t123yh/BM32/BM32/BM32.kicad_pcb

## KiCad design BM32/BM32.kicad_pcb (2022-07-28)

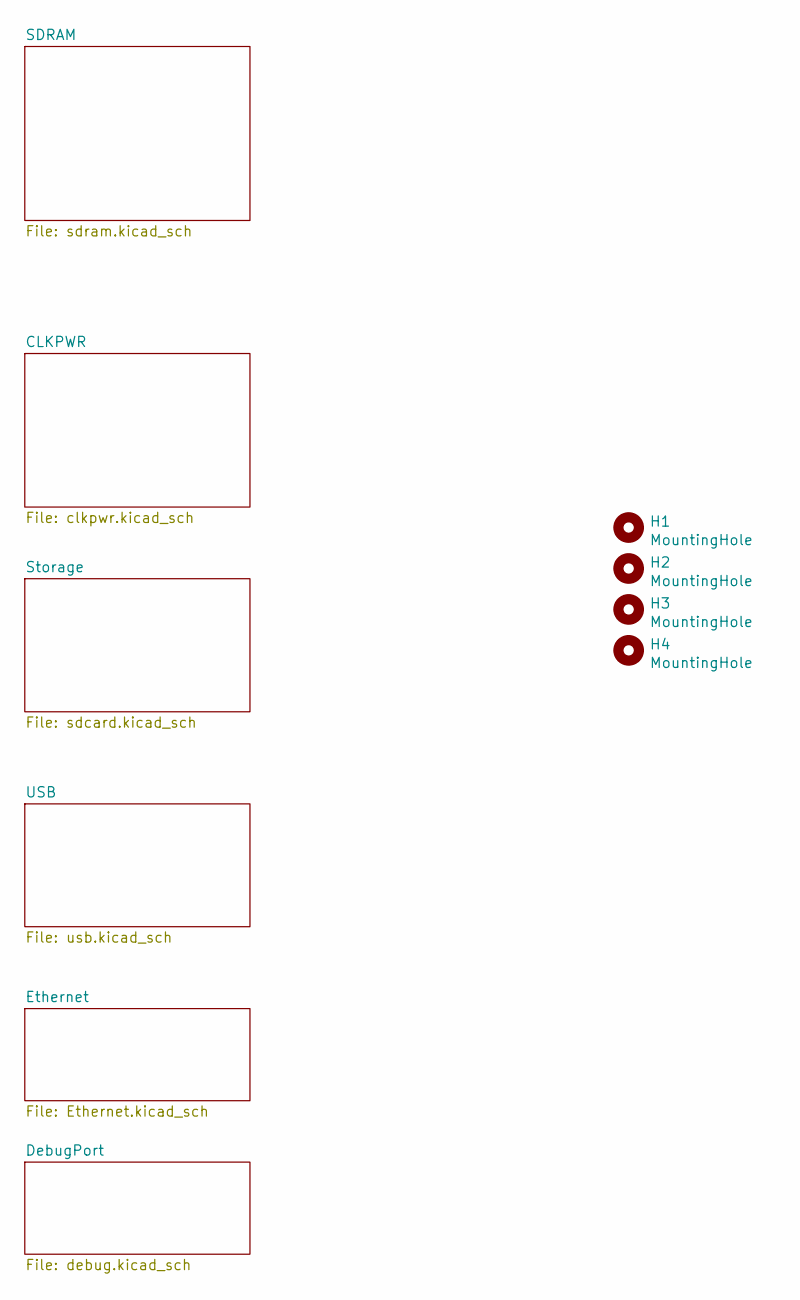
[picture p1: schematic BM32.kicad_sch]

Parts:
H1, H2, H3, H4: MountingHole; MountingHole_3.2mm_M3

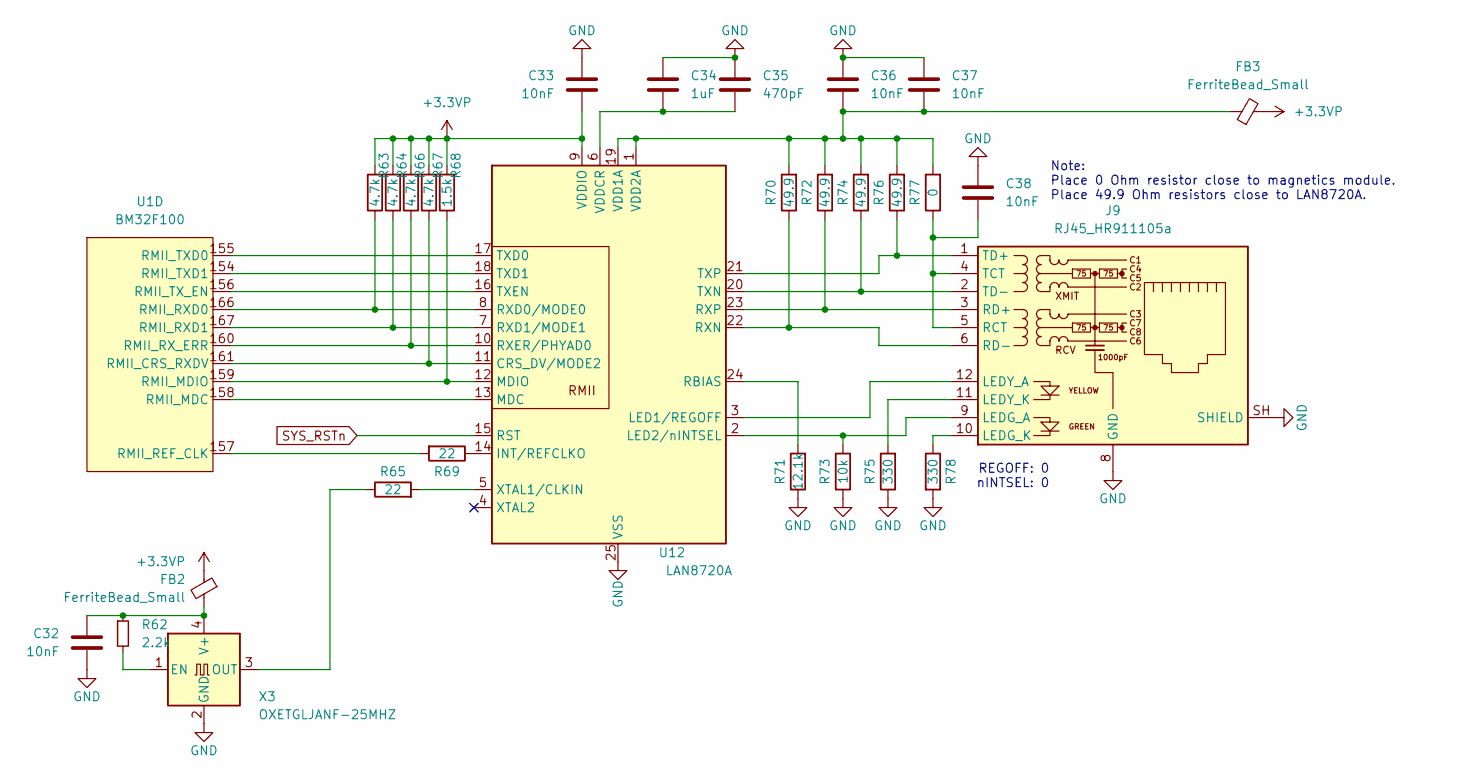
[picture p2: schematic Ethernet.kicad_sch, Ethernet Phy]

Parts:
C32, C33, C36, C37, C38: 10nF; 0402_C
C34: 1uF; 0402_C
C35: 470pF; 0402_C
FB2, FB3: FerriteBead_Small; 0805_L
J9: RJ45_HR911105a; RJ45_Hanrun_HR911105A
R62: 2.2k; 0402_R
R63, R64, R66, R67: 4.7k; 0402_R
R65, R69: 22; 0402_R
R68: 1.5k; 0402_R
R70, R72, R74, R76: 49.9; 0402_R
R71: 12.1k; 0402_R
R73: 10k; 0402_R
R75, R78: 330; 0402_R
R77: 0; 0402_R
U1: BM32F100; VQFP-176_20x20mm_P0.4mm
U12: LAN8720A; QFN-24-1EP_4x4mm_P0.5mm_EP2.6x2.6mm_ThermalVias
X3: OXETGLJANF-25MHZ; SMD-3225_4P

Connections:
+3.3VP: C33.2, FB2.1, FB3.2, R63.2, R64.2, R66.2, R67.2, R68.2, U12.9 (VDDIO); also elsewhere on the board
GND: C32.1, C33.1, C34.1, C35.1, C36.1, C37.1, C38.1, J9.8 (GND), J9.SH (SHIELD), R71.1, R73.1, R75.1, R78.2, U12.25 (VSS), X3.2 (GND); also elsewhere on the board
unnamed: C32.2, FB2.2, R62.1, X3.4 (V+)
unnamed: C34.2, C35.2, U12.6 (VDDCR)
unnamed: C36.2, C37.2, FB3.1, R70.2, R72.2, R74.2, R76.2, R77.2, U12.1 (VDD2A), U12.19 (VDD1A)
unnamed: C38.2, J9.4 (TCT), J9.5 (RCT), R77.1
unnamed: J9.1 (TD+), R76.1, U12.21 (TXP)
unnamed: J9.2 (TD-), R74.1, U12.20 (TXN)
unnamed: J9.3 (RD+), R72.1, U12.23 (RXP)
unnamed: J9.6 (RD-), R70.1, U12.22 (RXN)
unnamed: J9.9 (LEDG_A), R73.2, U12.2 (LED2/nINTSEL)
unnamed: J9.10 (LEDG_K), R78.1
unnamed: J9.11 (LEDY_K), R75.2
unnamed: J9.12 (LEDY_A), U12.3 (LED1/REGOFF)
unnamed: R62.2, X3.1 (EN)
unnamed: R63.1, U1.166 (RMII_RXD0), U12.8 (RXD0/MODE0)
unnamed: R64.1, U1.167 (RMII_RXD1), U12.7 (RXD1/MODE1)
unnamed: R65.1, X3.3 (OUT)
unnamed: R65.2, U12.5 (XTAL1/CLKIN)
unnamed: R66.1, U1.160 (RMII_RX_ERR), U12.10 (RXER/PHYAD0)
unnamed: R67.1, U1.161 (RMII_CRS_RXDV), U12.11 (CRS_DV/MODE2)
unnamed: R68.1, U1.159 (RMII_MDIO), U12.12 (MDIO)
unnamed: R69.1, U12.14 (INT/REFCLKO)
unnamed: R69.2, U1.157 (RMII_REF_CLK)
unnamed: R71.2, U12.24 (RBIAS)
unnamed: U1.154 (RMII_TXD1), U12.18 (TXD1)
unnamed: U1.155 (RMII_TXD0), U12.17 (TXD0)
unnamed: U1.156 (RMII_TX_EN), U12.16 (TXEN)
unnamed: U1.158 (RMII_MDC), U12.13 (MDC)
SYS_RSTn: U12.15 (RST); also elsewhere on the board

Notes on the sheet:
REGOFF: 0 nINTSEL: 0
Note: Place 0 Ohm resistor close to magnetics module. Place 49.9 Ohm resistors close to LAN8720A.

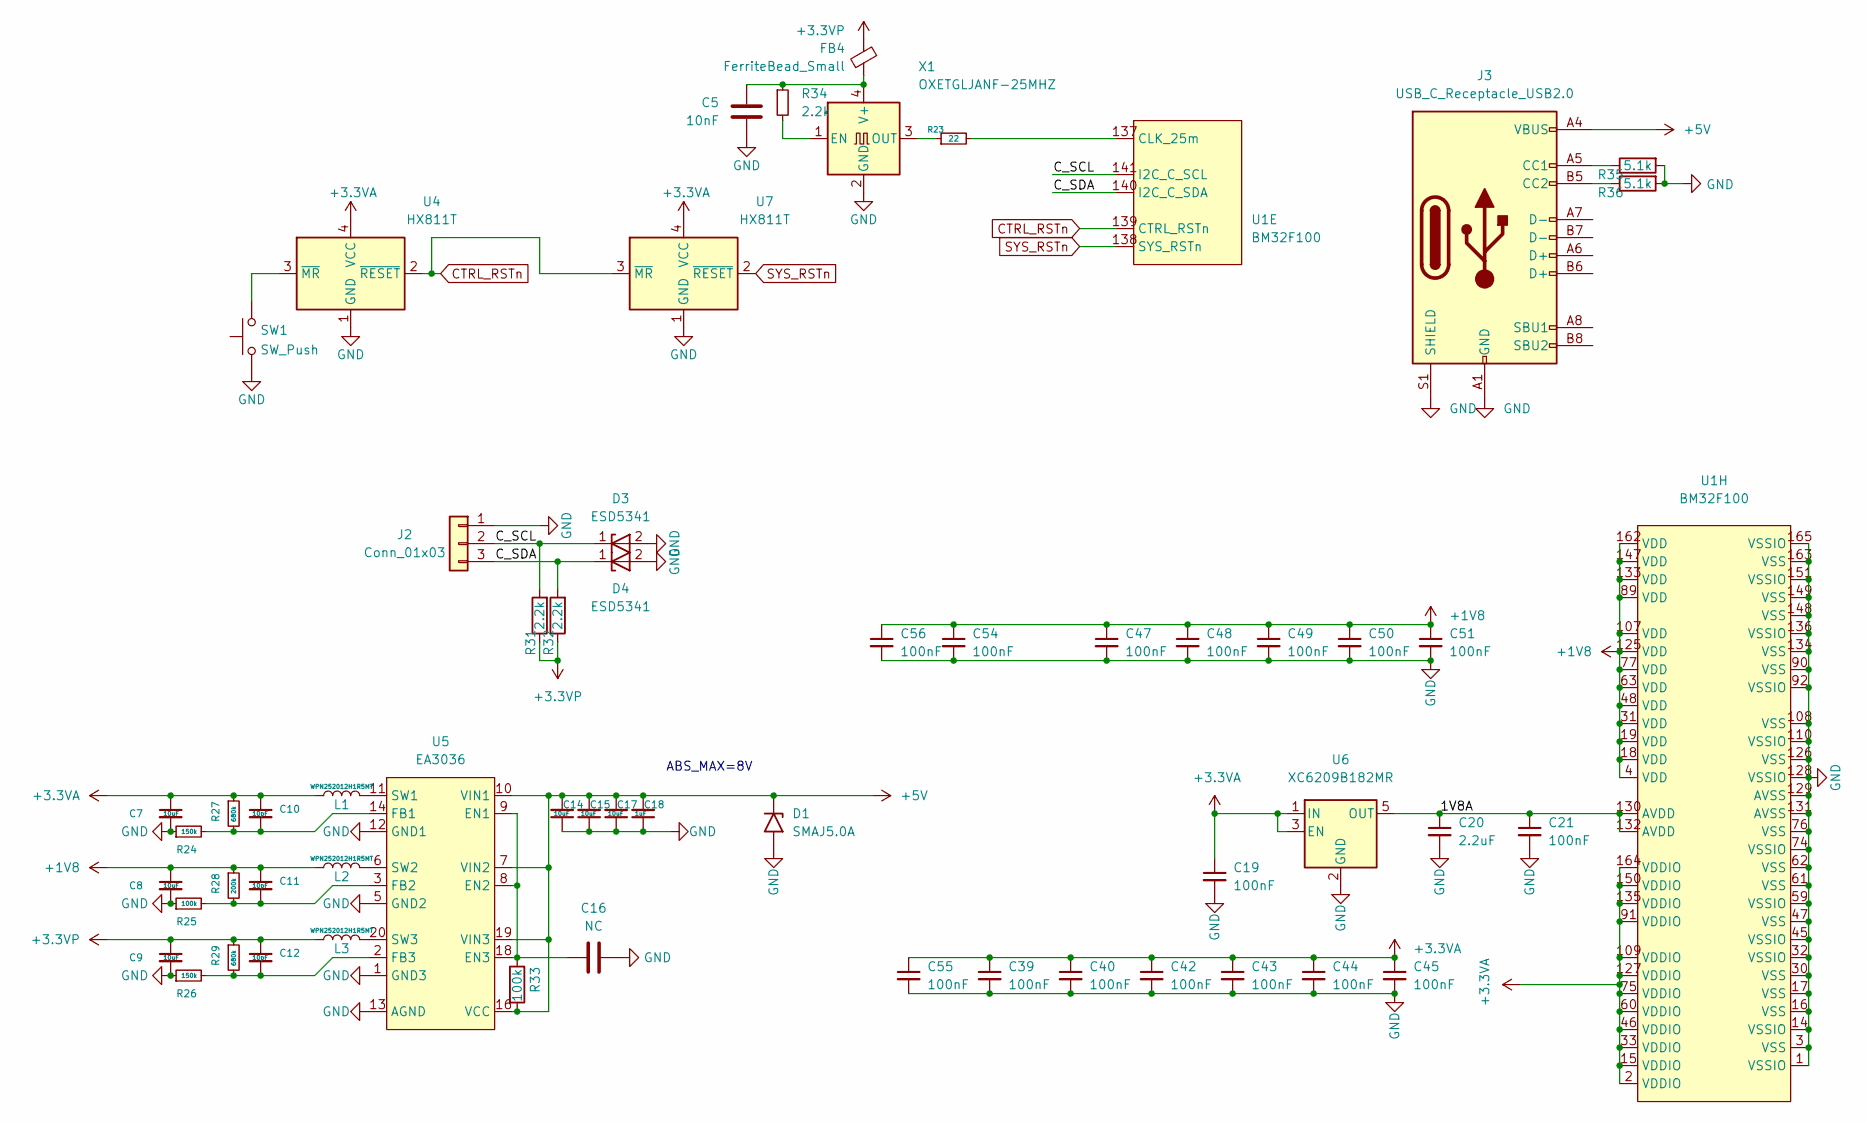
[picture p3: schematic clkpwr.kicad_sch, Clock and Power]

Parts:
C5: 10nF; 0402_C
C7, C8, C9, C14, C15, C17: 10uF; 0805_C
C10, C11, C12: 10pF; 0402_C
C16: NC; 0402_C
C18: 1uF; 0402_C
C19, C21, C39, C40, C42, C43, C44, C45, C47, C48, C49, C50, C51, C54, C55, C56: 100nF; 0402_C
C20: 2.2uF; 0402_C
D1: SMAJ5.0A; D_SMA
D3, D4: ESD5341; 0402_R
FB4: FerriteBead_Small; 0805_L
J2: Conn_01x03; PinHeader_1x03_P2.54mm_Vertical
J3: USB_C_Receptacle_USB2.0; USB_C_Receptacle_HRO_TYPE-C-31-M-12
L1, L2, L3: WPN252012H1R5MT; L_1008_2520Metric
R23: 22; 0402_R
R24, R26: 150k; 0402_R
R25, R33: 100k; 0402_R
R27, R29: 680k; 0402_R
R28: 200k; 0402_R
R31, R32, R34: 2.2k; 0402_R
R35, R36: 5.1k; 0402_R
SW1: SW_Push; SW_Push_SPST_NO_Alps_SKRK
U1: BM32F100; VQFP-176_20x20mm_P0.4mm
U4, U7: HX811T; SOT-143
U5: EA3036; QFN-20-1EP_3x3mm_P0.4mm_EP1.65x1.65mm_ThermalVias
U6: XC6209B182MR; SOT-23-5
X1: OXETGLJANF-25MHZ; SMD-3225_4P

Connections:
+1V8: C8.1, C11.1, C47.1, C48.1, C49.1, C50.1, C51.1, C54.1, C56.1, L2.1, R28.1, U1.4 (VDD), U1.18 (VDD), U1.19 (VDD), U1.31 (VDD), U1.48 (VDD), U1.63 (VDD), U1.77 (VDD), U1.89 (VDD), U1.107 (VDD), U1.125 (VDD), U1.133 (VDD), U1.147 (VDD), U1.162 (VDD); also elsewhere on the board
+3.3VA: C7.1, C10.1, C19.1, C39.1, C40.1, C42.1, C43.1, C44.1, C45.1, C55.1, L1.1, R27.1, U1.2 (VDDIO), U1.15 (VDDIO), U1.33 (VDDIO), U1.46 (VDDIO), U1.60 (VDDIO), U1.75 (VDDIO), U1.91 (VDDIO), U1.109 (VDDIO), U1.127 (VDDIO), U1.135 (VDDIO), U1.150 (VDDIO), U1.164 (VDDIO), U4.4 (VCC), U6.1 (IN), U6.3 (EN), U7.4 (VCC); also elsewhere on the board
+3.3VP: C9.1, C12.1, FB4.1, L3.1, R29.1, R31.1, R32.1; also elsewhere on the board
+5V: C14.2, C15.2, C17.2, C18.2, D1.1 (A1), J3.A4 (VBUS), J3.A9 (VBUS), J3.B4 (VBUS), J3.B9 (VBUS), R33.2, U5.7 (VIN2), U5.10 (VIN1), U5.16 (VCC), U5.19 (VIN3); also elsewhere on the board
/CLKPWR/1V8A: C20.1, C21.1, U1.130 (AVDD), U1.132 (AVDD), U6.5 (OUT)
/CLKPWR/C_SCL: D3.1, J2.2, R31.2, U1.141 (I2C_C_SCL)
/CLKPWR/C_SDA: D4.1, J2.3, R32.2, U1.140 (I2C_C_SDA)
CTRL_RSTn: U1.139 (CTRL_RSTn), U4.2 (~RESET), U7.3 (~MR)
GND: C5.1, C7.2, C8.2, C9.2, C14.1, C15.1, C16.2, C17.1, C18.1, C19.2, C20.2, C21.2, C39.2, C40.2, C42.2, C43.2, C44.2, C45.2, C47.2, C48.2, C49.2, C50.2, C51.2, C54.2, C55.2, C56.2, D1.2 (A2), D3.2, D4.2, J2.1, J3.A1 (GND), J3.A12 (GND), J3.B1 (GND), J3.B12 (GND), J3.S1 (SHIELD), R24.1, R25.1, R26.1, R35.2, R36.2, SW1.1, U1.1 (VSSIO), U1.3 (VSS), U1.14 (VSSIO), U1.16 (VSS), U1.17 (VSS), U1.30 (VSS), U1.32 (VSSIO), U1.45 (VSSIO), U1.47 (VSS), U1.59 (VSSIO), U1.61 (VSS), U1.62 (VSS), U1.74 (VSSIO), U1.76 (VSS), U1.90 (VSS), U1.92 (VSSIO), U1.108 (VSS), U1.110 (VSSIO), U1.126 (VSS), U1.128 (VSSIO), U1.129 (AVSS), U1.131 (AVSS), U1.134 (VSS), U1.136 (VSSIO), U1.148 (VSS), U1.149 (VSS), U1.151 (VSSIO), U1.163 (VSS), U1.165 (VSSIO), U4.1 (GND), U5.1 (GND3), U5.4 (AGND), U5.5 (GND2), U5.12 (GND1), U5.13 (AGND), U5.15 (AGND), U5.17 (AGND), U5.21 (EP), U6.2 (GND), U7.1 (GND), X1.2 (GND); also elsewhere on the board
unnamed: C5.2, FB4.2, R34.1, X1.4 (V+)
unnamed: C10.2, R24.2, R27.2, U5.14 (FB1)
unnamed: C11.2, R25.2, R28.2, U5.3 (FB2)
unnamed: C12.2, R26.2, R29.2, U5.2 (FB3)
unnamed: C16.1, R33.1, U5.8 (EN2), U5.9 (EN1), U5.18 (EN3)
unnamed: J3.A5 (CC1), R35.1
unnamed: J3.B5 (CC2), R36.1
unnamed: L1.2, U5.11 (SW1)
unnamed: L2.2, U5.6 (SW2)
unnamed: L3.2, U5.20 (SW3)
unnamed: R23.1, X1.3 (OUT)
unnamed: R23.2, U1.137 (CLK_25m)
unnamed: R34.2, X1.1 (EN)
unnamed: SW1.2, U4.3 (~MR)
SYS_RSTn: U1.138 (SYS_RSTn), U7.2 (~RESET); also elsewhere on the board

Notes on the sheet:
ABS_MAX=8V

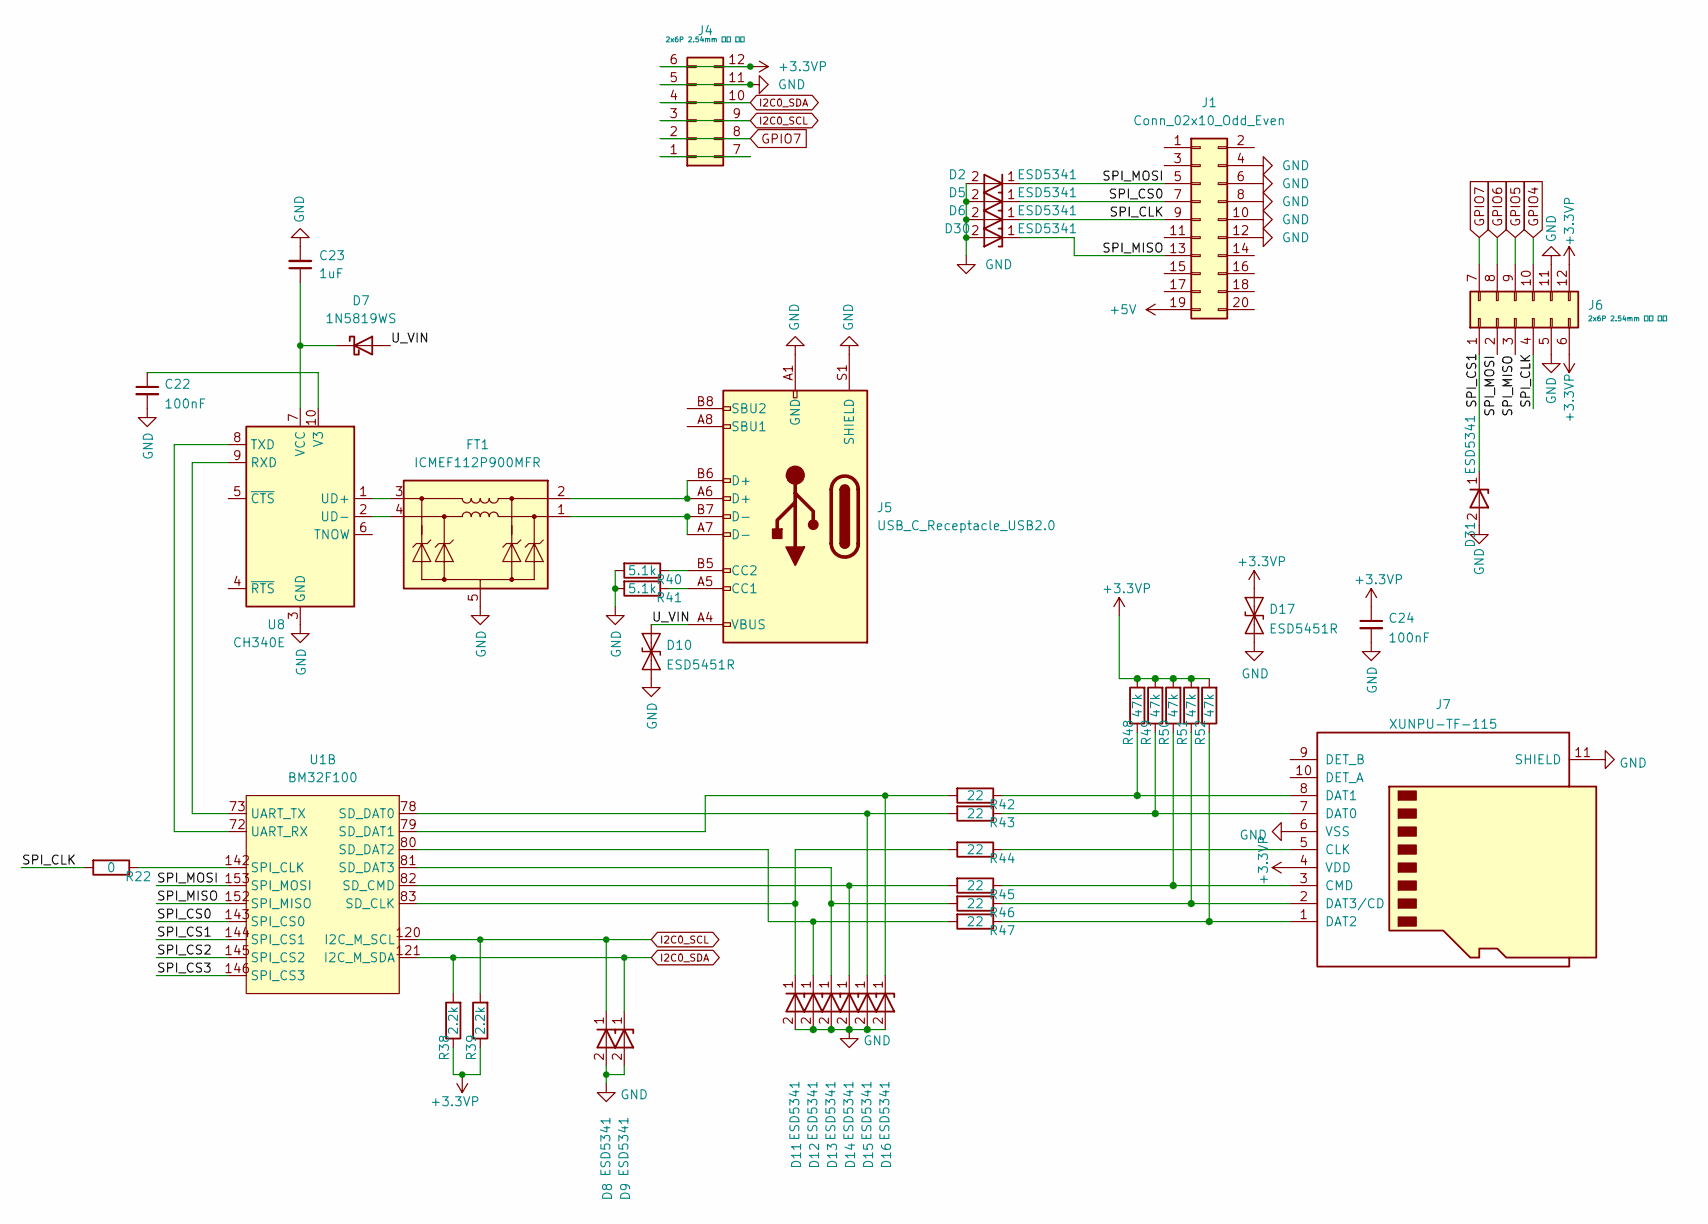
[picture p4: schematic sdcard.kicad_sch, SDCard, SPI and USB-UART]

Parts:
C22, C24: 100nF; 0402_C
C23: 1uF; 0402_C
D2, D5, D6, D8, D9, D11, D12, D13, D14, D15, D16, D30, D31: ESD5341; 0402_R
D7: 1N5819WS; SOD-323
D10, D17: ESD5451R; 0402_R
FT1: ICMEF112P900MFR
J1: Conn_02x10_Odd_Even; PinHeader_2x10_P2.54mm_Vertical
J4: 2x6P 2.54mm 弯针 母座; PinSocket_2x06_P2.54mm_Horizontal_PMOD
J5: USB_C_Receptacle_USB2.0; USB_C_Receptacle_HRO_TYPE-C-31-M-12
J6: 2x6P 2.54mm 弯针 母座; PinSocket_2x06_P2.54mm_Vertical_PMOD
J7: XUNPU-TF-115
R22: 0; 0402_R
R38, R39: 2.2k; 0402_R
R40, R41: 5.1k; 0402_R
R42, R43, R44, R45, R46, R47: 22; 0402_R
R48, R49, R50, R51, R52: 47k; 0402_R
U1: BM32F100; VQFP-176_20x20mm_P0.4mm
U8: CH340E; MSOP-10_3x3mm_P0.5mm

Connections:
+3.3VP: C24.1, D17.2 (A2), J4.6, J4.12, J6.6, J6.12, J7.4 (VDD), R38.1, R39.1, R48.2, R49.2, R50.2, R51.2, R52.2; also elsewhere on the board
+5V: J1.19; also elsewhere on the board
/Storage/SPI_CLK: D6.1, J1.9, J6.4, R22.2
/Storage/SPI_CS0: D5.1, J1.7, U1.143 (SPI_CS0)
/Storage/SPI_CS1: D31.1, J6.1, U1.144 (SPI_CS1)
/Storage/SPI_CS2: U1.145 (SPI_CS2)
/Storage/SPI_CS3: U1.146 (SPI_CS3)
/Storage/SPI_MISO: D30.1, J1.13, J6.3, U1.152 (SPI_MISO)
/Storage/SPI_MOSI: D2.1, J1.5, J6.2, U1.153 (SPI_MOSI)
/Storage/U_VIN: D7.2 (A), D10.2 (A2), J5.A4 (VBUS), J5.A9 (VBUS), J5.B4 (VBUS), J5.B9 (VBUS)
GND: C22.2, C23.2, C24.2, D2.2, D5.2, D6.2, D8.2, D9.2, D10.1 (A1), D11.2, D12.2, D13.2, D14.2, D15.2, D16.2, D17.1 (A1), D30.2, D31.2, FT1.5 (GND), FT1.6 (GND), J1.4, J1.6, J1.8, J1.10, J1.12, J4.5, J4.11, J5.A1 (GND), J5.A12 (GND), J5.B1 (GND), J5.B12 (GND), J5.S1 (SHIELD), J6.5, J6.11, J7.6 (VSS), J7.11 (SHIELD), R40.2, R41.2, U8.3 (GND); also elsewhere on the board
GPIO4: J6.10; also elsewhere on the board
GPIO5: J6.9; also elsewhere on the board
GPIO6: J6.8; also elsewhere on the board
GPIO7: J4.2, J4.8, J6.7; also elsewhere on the board
I2C0_SCL: D8.1, J4.3, J4.9, R39.2, U1.120 (I2C_M_SCL)
I2C0_SDA: D9.1, J4.4, J4.10, R38.2, U1.121 (I2C_M_SDA)
unnamed: C22.1, U8.10 (V3)
unnamed: C23.1, D7.1 (K), U8.7 (VCC)
unnamed: D11.1, R44.2, U1.83 (SD_CLK)
unnamed: D12.1, R47.2, U1.80 (SD_DAT2)
unnamed: D13.1, R46.2, U1.81 (SD_DAT3)
unnamed: D14.1, R45.2, U1.82 (SD_CMD)
unnamed: D15.1, R43.2, U1.78 (SD_DAT0)
unnamed: D16.1, R42.2, U1.79 (SD_DAT1)
unnamed: FT1.1 (In_1+), J5.A7 (D-), J5.B7 (D-)
unnamed: FT1.2 (In_1-), J5.A6 (D+), J5.B6 (D+)
unnamed: FT1.3 (Out_1-), U8.1 (UD+)
unnamed: FT1.4 (Out_1+), U8.2 (UD-)
unnamed: J4.1, J4.7
unnamed: J5.A5 (CC1), R41.1
unnamed: J5.B5 (CC2), R40.1
unnamed: J7.1 (DAT2), R47.1, R52.1
unnamed: J7.2 (DAT3/CD), R46.1, R51.1
unnamed: J7.3 (CMD), R45.1, R50.1
unnamed: J7.5 (CLK), R44.1
unnamed: J7.7 (DAT0), R43.1, R49.1
unnamed: J7.8 (DAT1), R42.1, R48.1
unnamed: R22.1, U1.142 (SPI_CLK)
unnamed: U1.72 (UART_RX), U8.8 (TXD)
unnamed: U1.73 (UART_TX), U8.9 (RXD)

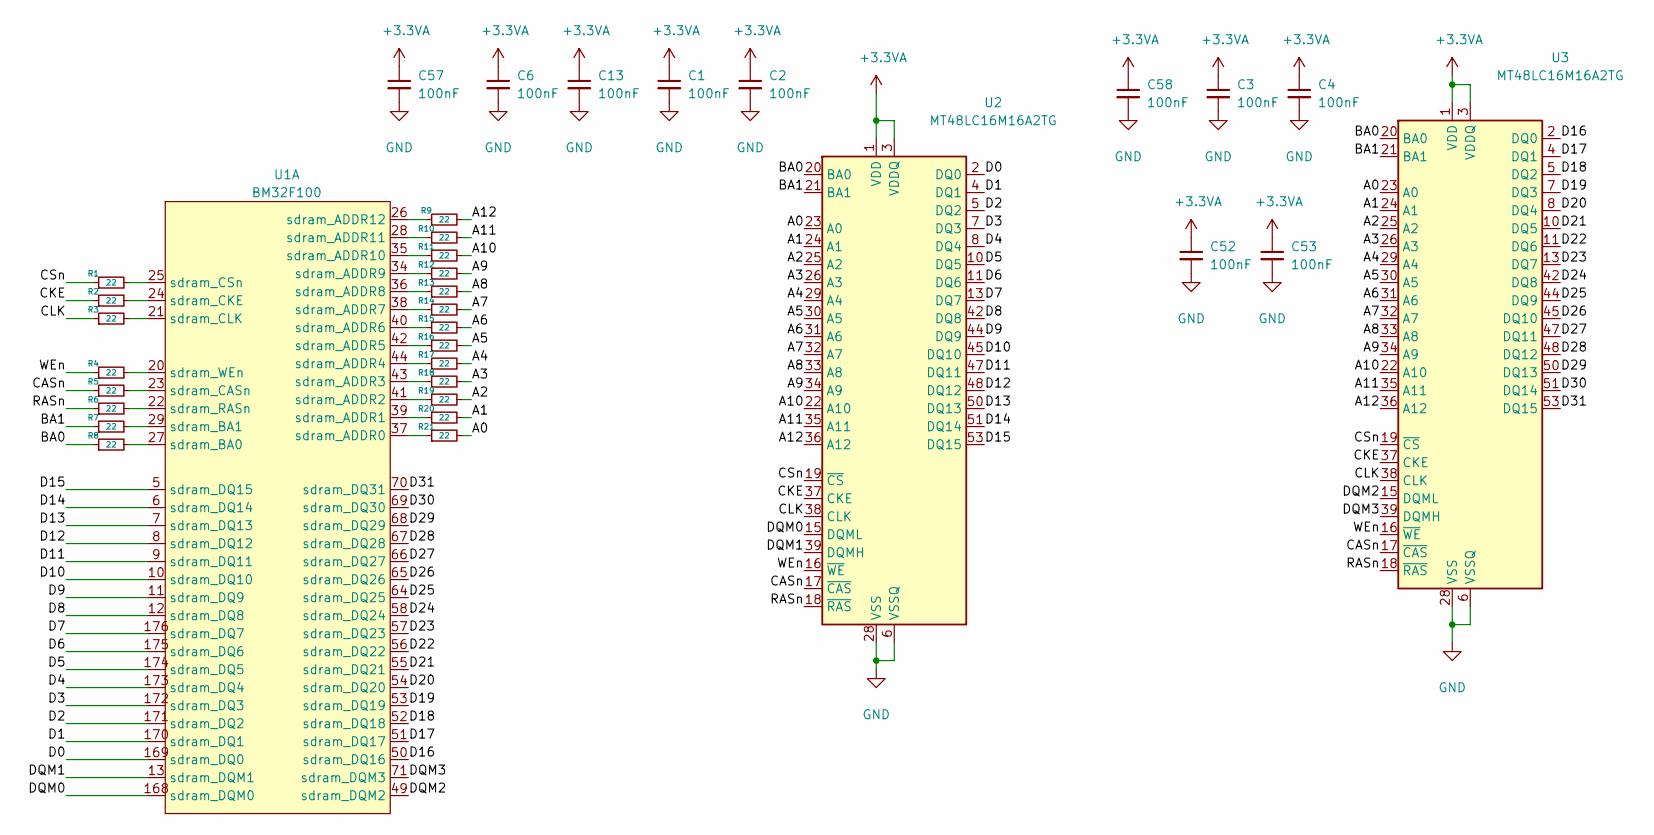
[picture p5: schematic sdram.kicad_sch, SDRAM Memory]

Parts:
C1, C2, C3, C4, C6, C13, C52, C53, C57, C58: 100nF; 0402_C
R1, R2, R3, R4, R5, R6, R7, R8, R9, R10, R11, R12, R13, R14, R15, R16, R17, R18, R19, R20, R21: 22; 0402_R
U1: BM32F100; VQFP-176_20x20mm_P0.4mm
U2, U3: MT48LC16M16A2TG; TSOP-II-54_22.2x10.16mm_P0.8mm

Connections:
+3.3VA: C1.1, C2.1, C3.1, C4.1, C6.1, C13.1, C52.1, C53.1, C57.1, C58.1, U2.1 (VDD), U2.3 (VDDQ), U2.9 (VDDQ), U2.14 (VDD), U2.27 (VDD), U2.43 (VDDQ), U2.49 (VDDQ), U3.1 (VDD), U3.3 (VDDQ), U3.9 (VDDQ), U3.14 (VDD), U3.27 (VDD), U3.43 (VDDQ), U3.49 (VDDQ); also elsewhere on the board
/SDRAM/A0: R21.2, U2.23 (A0), U3.23 (A0)
/SDRAM/A1: R20.2, U2.24 (A1), U3.24 (A1)
/SDRAM/A2: R19.2, U2.25 (A2), U3.25 (A2)
/SDRAM/A3: R18.2, U2.26 (A3), U3.26 (A3)
/SDRAM/A4: R17.2, U2.29 (A4), U3.29 (A4)
/SDRAM/A5: R16.2, U2.30 (A5), U3.30 (A5)
/SDRAM/A6: R15.2, U2.31 (A6), U3.31 (A6)
/SDRAM/A7: R14.2, U2.32 (A7), U3.32 (A7)
/SDRAM/A8: R13.2, U2.33 (A8), U3.33 (A8)
/SDRAM/A9: R12.2, U2.34 (A9), U3.34 (A9)
/SDRAM/A10: R11.2, U2.22 (A10), U3.22 (A10)
/SDRAM/A11: R10.2, U2.35 (A11), U3.35 (A11)
/SDRAM/A12: R9.2, U2.36 (A12), U3.36 (A12)
/SDRAM/BA0: R8.1, U2.20 (BA0), U3.20 (BA0)
/SDRAM/BA1: R7.1, U2.21 (BA1), U3.21 (BA1)
/SDRAM/CASn: R5.1, U2.17 (~CAS), U3.17 (~CAS)
/SDRAM/CKE: R2.1, U2.37 (CKE), U3.37 (CKE)
/SDRAM/CLK: R3.1, U2.38 (CLK), U3.38 (CLK)
/SDRAM/CSn: R1.1, U2.19 (~CS), U3.19 (~CS)
/SDRAM/D0: U1.169 (sdram_DQ0), U2.2 (DQ0)
/SDRAM/D1: U1.170 (sdram_DQ1), U2.4 (DQ1)
/SDRAM/D2: U1.171 (sdram_DQ2), U2.5 (DQ2)
/SDRAM/D3: U1.172 (sdram_DQ3), U2.7 (DQ3)
/SDRAM/D4: U1.173 (sdram_DQ4), U2.8 (DQ4)
/SDRAM/D5: U1.174 (sdram_DQ5), U2.10 (DQ5)
/SDRAM/D6: U1.175 (sdram_DQ6), U2.11 (DQ6)
/SDRAM/D7: U1.176 (sdram_DQ7), U2.13 (DQ7)
/SDRAM/D8: U1.12 (sdram_DQ8), U2.42 (DQ8)
/SDRAM/D9: U1.11 (sdram_DQ9), U2.44 (DQ9)
/SDRAM/D10: U1.10 (sdram_DQ10), U2.45 (DQ10)
/SDRAM/D11: U1.9 (sdram_DQ11), U2.47 (DQ11)
/SDRAM/D12: U1.8 (sdram_DQ12), U2.48 (DQ12)
/SDRAM/D13: U1.7 (sdram_DQ13), U2.50 (DQ13)
/SDRAM/D14: U1.6 (sdram_DQ14), U2.51 (DQ14)
/SDRAM/D15: U1.5 (sdram_DQ15), U2.53 (DQ15)
/SDRAM/D16: U1.50 (sdram_DQ16), U3.2 (DQ0)
/SDRAM/D17: U1.51 (sdram_DQ17), U3.4 (DQ1)
/SDRAM/D18: U1.52 (sdram_DQ18), U3.5 (DQ2)
/SDRAM/D19: U1.53 (sdram_DQ19), U3.7 (DQ3)
/SDRAM/D20: U1.54 (sdram_DQ20), U3.8 (DQ4)
/SDRAM/D21: U1.55 (sdram_DQ21), U3.10 (DQ5)
/SDRAM/D22: U1.56 (sdram_DQ22), U3.11 (DQ6)
/SDRAM/D23: U1.57 (sdram_DQ23), U3.13 (DQ7)
/SDRAM/D24: U1.58 (sdram_DQ24), U3.42 (DQ8)
/SDRAM/D25: U1.64 (sdram_DQ25), U3.44 (DQ9)
/SDRAM/D26: U1.65 (sdram_DQ26), U3.45 (DQ10)
/SDRAM/D27: U1.66 (sdram_DQ27), U3.47 (DQ11)
/SDRAM/D28: U1.67 (sdram_DQ28), U3.48 (DQ12)
/SDRAM/D29: U1.68 (sdram_DQ29), U3.50 (DQ13)
/SDRAM/D30: U1.69 (sdram_DQ30), U3.51 (DQ14)
/SDRAM/D31: U1.70 (sdram_DQ31), U3.53 (DQ15)
/SDRAM/DQM0: U1.168 (sdram_DQM0), U2.15 (DQML)
/SDRAM/DQM1: U1.13 (sdram_DQM1), U2.39 (DQMH)
/SDRAM/DQM2: U1.49 (sdram_DQM2), U3.15 (DQML)
/SDRAM/DQM3: U1.71 (sdram_DQM3), U3.39 (DQMH)
/SDRAM/RASn: R6.1, U2.18 (~RAS), U3.18 (~RAS)
/SDRAM/WEn: R4.1, U2.16 (~WE), U3.16 (~WE)
GND: C1.2, C2.2, C3.2, C4.2, C6.2, C13.2, C52.2, C53.2, C57.2, C58.2, U2.6 (VSSQ), U2.12 (VSSQ), U2.28 (VSS), U2.41 (VSS), U2.46 (VSSQ), U2.52 (VSSQ), U2.54 (VSS), U3.6 (VSSQ), U3.12 (VSSQ), U3.28 (VSS), U3.41 (VSS), U3.46 (VSSQ), U3.52 (VSSQ), U3.54 (VSS); also elsewhere on the board
unnamed: R1.2, U1.25 (sdram_CSn)
unnamed: R2.2, U1.24 (sdram_CKE)
unnamed: R3.2, U1.21 (sdram_CLK)
unnamed: R4.2, U1.20 (sdram_WEn)
unnamed: R5.2, U1.23 (sdram_CASn)
unnamed: R6.2, U1.22 (sdram_RASn)
unnamed: R7.2, U1.29 (sdram_BA1)
unnamed: R8.2, U1.27 (sdram_BA0)
unnamed: R9.1, U1.26 (sdram_ADDR12)
unnamed: R10.1, U1.28 (sdram_ADDR11)
unnamed: R11.1, U1.35 (sdram_ADDR10)
unnamed: R12.1, U1.34 (sdram_ADDR9)
unnamed: R13.1, U1.36 (sdram_ADDR8)
unnamed: R14.1, U1.38 (sdram_ADDR7)
unnamed: R15.1, U1.40 (sdram_ADDR6)
unnamed: R16.1, U1.42 (sdram_ADDR5)
unnamed: R17.1, U1.44 (sdram_ADDR4)
unnamed: R18.1, U1.43 (sdram_ADDR3)
unnamed: R19.1, U1.41 (sdram_ADDR2)
unnamed: R20.1, U1.39 (sdram_ADDR1)
unnamed: R21.1, U1.37 (sdram_ADDR0)

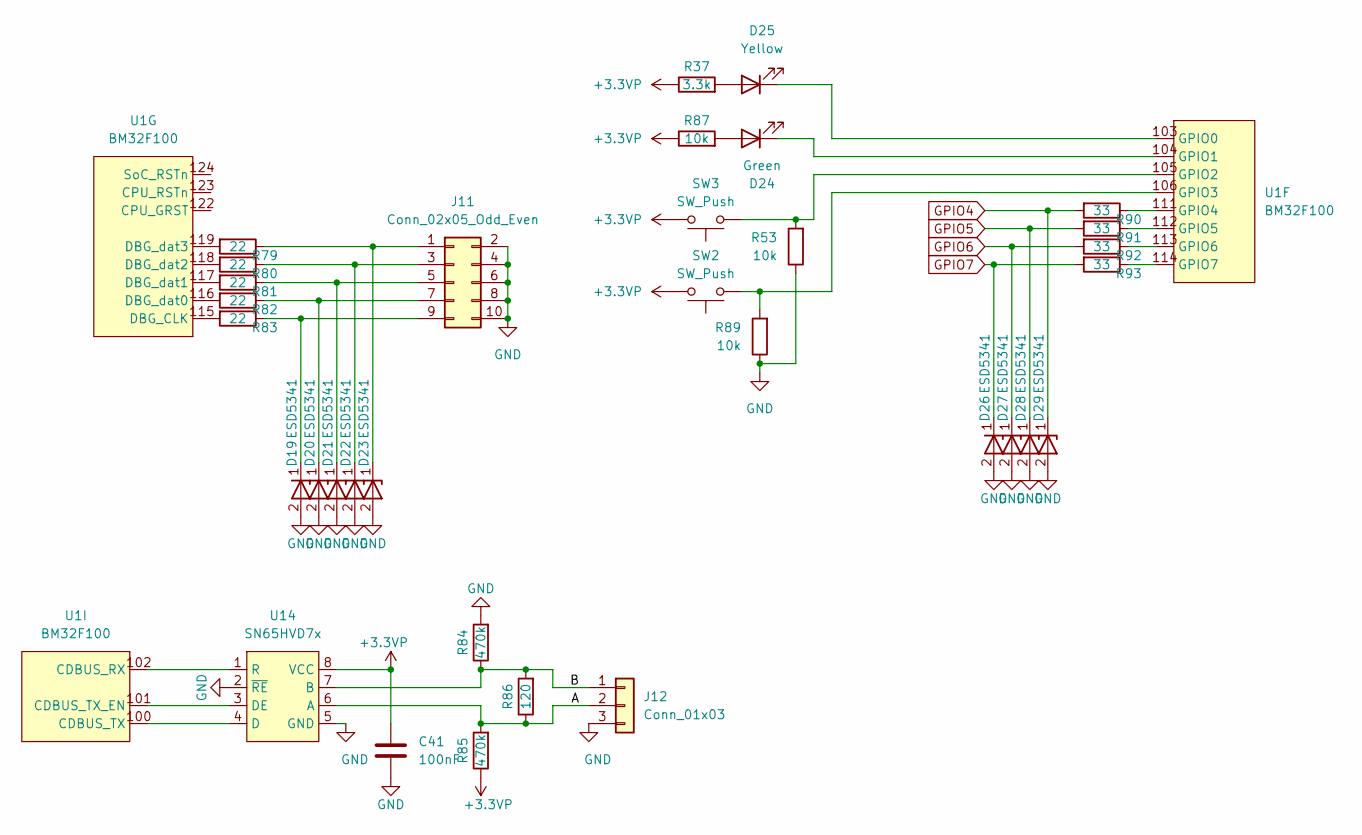
[picture p6: schematic debug.kicad_sch, Debug ports]

Parts:
C41: 100nF; 0402_C
D19, D20, D21, D22, D23, D26, D27, D28, D29: ESD5341; 0402_R
D24: Green; 0805_LED_S1_NUM
D25: Yellow; 0805_LED_S1_NUM
J11: Conn_02x05_Odd_Even; PinHeader_2x05_P1.27mm_Vertical
J12: Conn_01x03; PinSocket_1x03_P2.54mm_Vertical
R37: 3.3k; 0402_R
R53, R87, R89: 10k; 0402_R
R79, R80, R81, R82, R83: 22; 0402_R
R84, R85: 470k; 0402_R
R86: 120; 0402_R
R90, R91, R92, R93: 33; 0402_R
SW2, SW3: SW_Push; SW_Push_SPST_NO_Alps_SKRK
U1: BM32F100; VQFP-176_20x20mm_P0.4mm
U14: SN65HVD7x; SOIC-8_3.9x4.9mm_P1.27mm

Connections:
+3.3VP: C41.1, R37.1, R85.1, R87.1, SW2.2, SW3.2, U14.8 (VCC); also elsewhere on the board
/DebugPort/A: J12.2, R85.2, R86.1, U14.6 (A)
/DebugPort/B: J12.1, R84.1, R86.2, U14.7 (B)
GND: C41.2, D19.2, D20.2, D21.2, D22.2, D23.2, D26.2, D27.2, D28.2, D29.2, J11.2, J11.4, J11.6, J11.8, J11.10, J12.3, R53.1, R84.2, R89.1, U14.2 (~RE), U14.5 (GND), U14.9 (GND); also elsewhere on the board
GPIO4: D29.1, R90.2; also elsewhere on the board
GPIO5: D28.1, R91.2; also elsewhere on the board
GPIO6: D27.1, R92.2; also elsewhere on the board
GPIO7: D26.1, R93.2; also elsewhere on the board
unnamed: D19.1, J11.9, R83.1
unnamed: D20.1, J11.7, R82.1
unnamed: D21.1, J11.5, R81.1
unnamed: D22.1, J11.3, R80.1
unnamed: D23.1, J11.1, R79.1
unnamed: D24.1 (K), U1.104 (GPIO1)
unnamed: D24.2 (A), R87.2
unnamed: D25.2 (A), R37.2
unnamed: R79.2, U1.119 (DBG_dat3)
unnamed: R80.2, U1.118 (DBG_dat2)
unnamed: R81.2, U1.117 (DBG_dat1)
unnamed: R82.2, U1.116 (DBG_dat0)
unnamed: R83.2, U1.115 (DBG_CLK)
unnamed: R89.2, SW2.1, U1.106 (GPIO3)
unnamed: R90.1, U1.111 (GPIO4)
unnamed: R91.1, U1.112 (GPIO5)
unnamed: R92.1, U1.113 (GPIO6)
unnamed: R93.1, U1.114 (GPIO7)
unnamed: U1.100 (CDBUS_TX), U14.4 (D)
unnamed: U1.101 (CDBUS_TX_EN), U14.3 (DE)
unnamed: U1.102 (CDBUS_RX), U14.1 (R)
unnamed: D25.1 (K), U1.103 (GPIO0)
unnamed: R53.2, SW3.1, U1.105 (GPIO2)

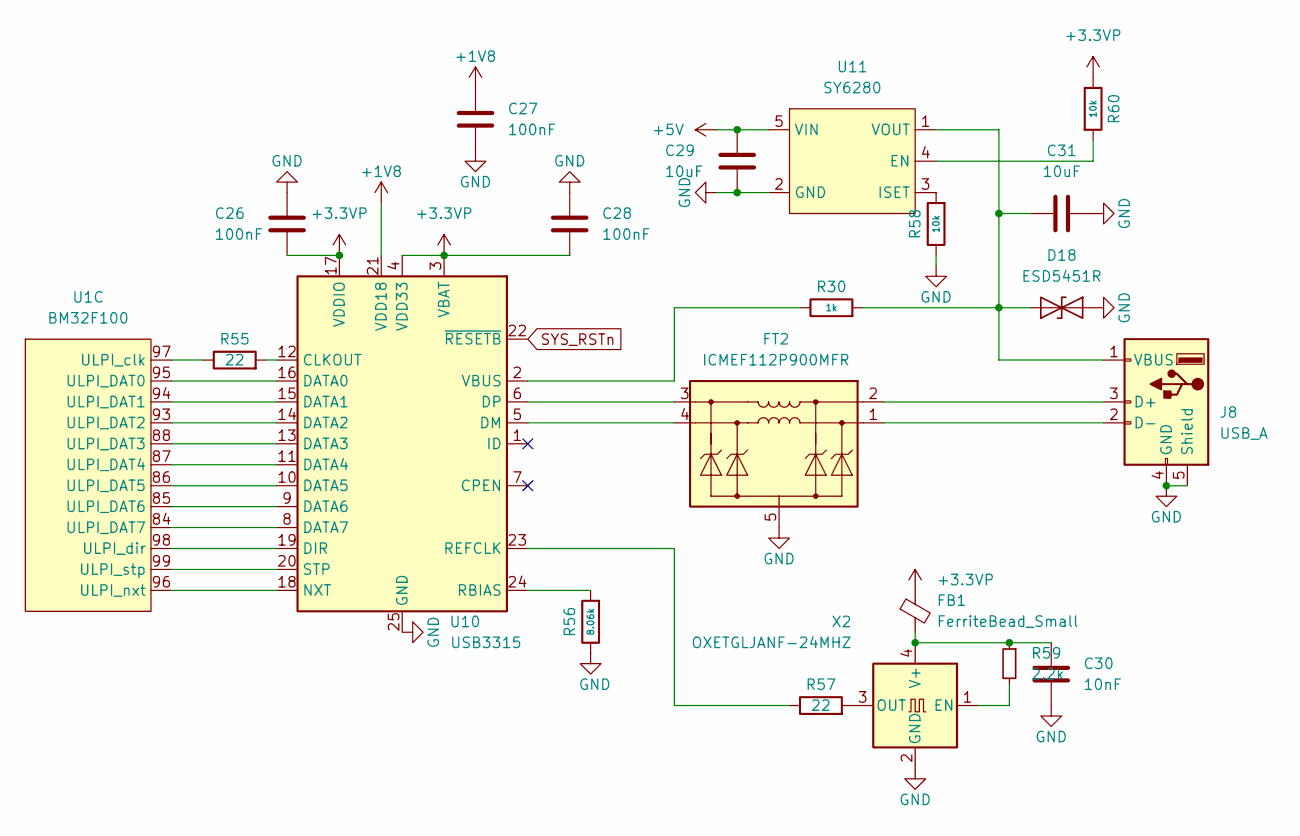
[picture p7: schematic usb.kicad_sch, USB Phy]

Parts:
C26, C27, C28: 100nF; 0402_C
C29, C31: 10uF; 0805_C
C30: 10nF; 0402_C
D18: ESD5451R; 0402_R
FB1: FerriteBead_Small; 0805_L
FT2: ICMEF112P900MFR
J8: USB_A; USB_A_Molex_67643_Horizontal; LCSC C2345
R30: 1k; 0402_R
R55, R57: 22; 0402_R
R56: 8.06k; 0402_R
R58, R60: 10k; 0402_R
R59: 2.2k; 0402_R
U1: BM32F100; VQFP-176_20x20mm_P0.4mm
U10: USB3315; QFN-24-1EP_4x4mm_P0.5mm_EP2.6x2.6mm_ThermalVias
U11: SY6280; SOT-23-5
X2: OXETGLJANF-24MHZ; SMD-3225_4P

Connections:
+1V8: C27.2, U10.21 (VDD18); also elsewhere on the board
+3.3VP: C26.2, C28.1, FB1.1, R60.1, U10.3 (VBAT), U10.4 (VDD33), U10.17 (VDDIO); also elsewhere on the board
+5V: C29.1, U11.5 (VIN); also elsewhere on the board
GND: C26.1, C27.1, C28.2, C29.2, C30.1, C31.1, D18.1 (A1), FT2.5 (GND), FT2.6 (GND), J8.4 (GND), J8.5 (Shield), R56.1, R58.1, U10.25 (GND), U11.2 (GND), X2.2 (GND); also elsewhere on the board
unnamed: C30.2, FB1.2, R59.1, X2.4 (V+)
unnamed: C31.2, D18.2 (A2), J8.1 (VBUS), R30.2, U11.1 (VOUT)
unnamed: FT2.1 (In_1+), J8.2 (D-)
unnamed: FT2.2 (In_1-), J8.3 (D+)
unnamed: FT2.3 (Out_1-), U10.6 (DP)
unnamed: FT2.4 (Out_1+), U10.5 (DM)
unnamed: R30.1, U10.2 (VBUS)
unnamed: R55.1, U1.97 (ULPI_clk)
unnamed: R55.2, U10.12 (CLKOUT)
unnamed: R56.2, U10.24 (RBIAS)
unnamed: R57.1, U10.23 (REFCLK)
unnamed: R57.2, X2.3 (OUT)
unnamed: R58.2, U11.3 (ISET)
unnamed: R59.2, X2.1 (EN)
unnamed: R60.2, U11.4 (EN)
unnamed: U1.84 (ULPI_DAT7), U10.8 (DATA7)
unnamed: U1.85 (ULPI_DAT6), U10.9 (DATA6)
unnamed: U1.86 (ULPI_DAT5), U10.10 (DATA5)
unnamed: U1.87 (ULPI_DAT4), U10.11 (DATA4)
unnamed: U1.88 (ULPI_DAT3), U10.13 (DATA3)
unnamed: U1.93 (ULPI_DAT2), U10.14 (DATA2)
unnamed: U1.94 (ULPI_DAT1), U10.15 (DATA1)
unnamed: U1.95 (ULPI_DAT0), U10.16 (DATA0)
unnamed: U1.96 (ULPI_nxt), U10.18 (NXT)
unnamed: U1.98 (ULPI_dir), U10.19 (DIR)
unnamed: U1.99 (ULPI_stp), U10.20 (STP)
SYS_RSTn: U10.22 (~RESETB); also elsewhere on the board

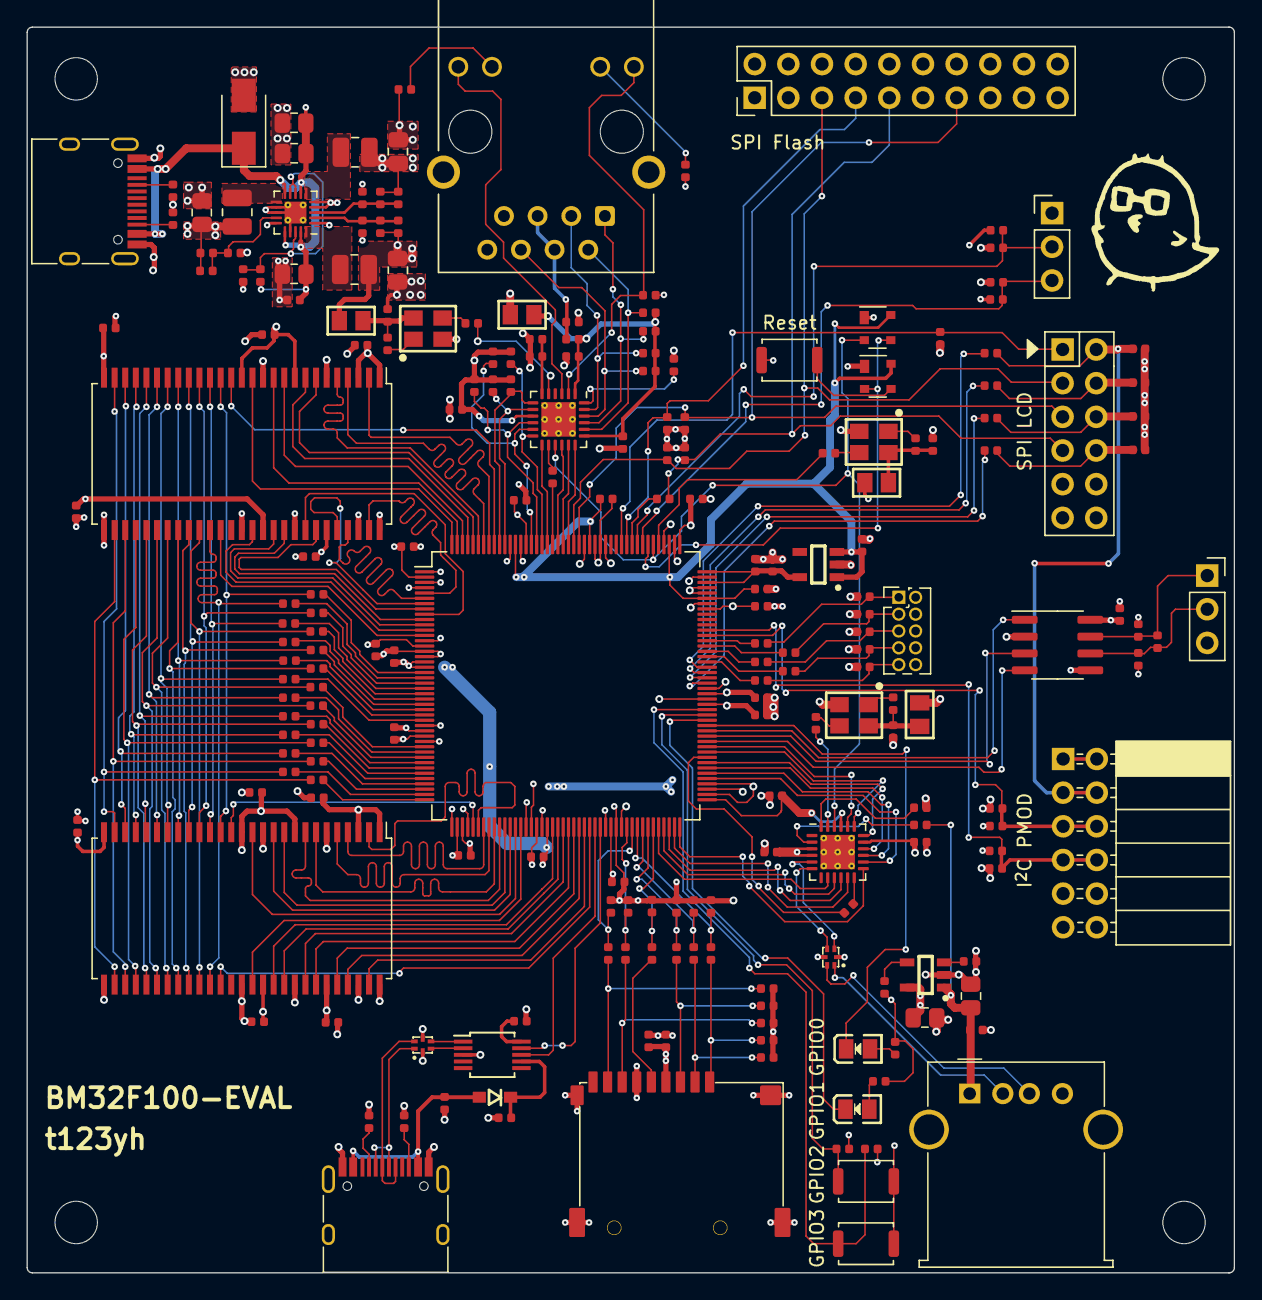
[picture p8: board BM32.kicad_pcb from above]

Board: 4 copper layers, 91.1 x 94.0 mm, 219 parts (0 on the bottom side), 216 nets.
