t123yh/BM32/BM32-SPI/BM32-SPI.kicad_pcb

## KiCad design BM32-SPI/BM32-SPI.kicad_pcb (2022-04-25)

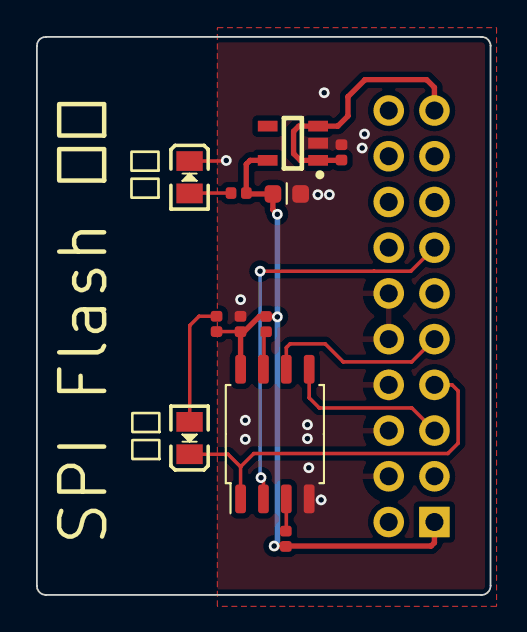
[picture p9: board BM32-SPI.kicad_pcb from above]

Board: 2 copper layers, 25.2 x 31.0 mm, 12 parts (1 on the bottom side), 11 nets.

Parts:
C1, C3: 100nF; 0402_C
C2: 2.2uF; 0603_C
D1: Green; 0805_LED_S1_NUM
D2: Red; 0805_LED_S1_NUM
J1: PinSocket_2x10_P2.54mm_Vertical
R1, R2: 2.2k; 0402_R
R3: 22k; 0402_R
R4: 6.8k; 0402_R
U1: XC6209F332MR; SOT-23-5
U2: W25Q32JVSS; SOIC-8_5.23x5.23mm_P1.27mm

Connections:
+3.3VP: C2.2, C3.1, J1.1, R1.2, R2.2, R3.2, R4.1, U1.5 (OUT), U2.8 (VCC)
+5V: C1.1, J1.19, U1.1 (IN), U1.3 (EN)
/SPI_CLK: J1.9, U2.6 (CLK)
/SPI_CS0: D2.1 (K), J1.7, U2.1 (~CS)
/SPI_MISO: J1.13, U2.2 (DO(IO1))
/SPI_MOSI: J1.5, U2.5 (DI(IO0))
GND: C1.2, C2.1, C3.2, D1.1 (K), J1.4, J1.6, J1.8, J1.10, J1.12, U1.2 (GND), U2.4 (GND)
unnamed: D2.2 (A), R4.2
unnamed: R1.1, U2.3 (IO2)
unnamed: R2.1, U2.7 (IO3)
unnamed: D1.2 (A), R3.1
